LarsMolenschot/8x8_RGB_LED_CUBE/Spice_simulations/Power_rail_transients.asc

C1: cap; C10uF
C2: cap; C0.1uF
C3: cap; C0.1uF
C4: cap; C100pF
C5: cap; C0.1uF
C6: cap; C22uF
C7: cap; C22uF
D1: LED; D_RLED
D2: LED; D_RLED
D3: LED; D_RLED
D4: LED; D_RLED
D5: LED; D_RLED
D6: LED; D_RLED
D7: LED; D_RLED
D8: LED; D_RLED
L1: ind; 4.7µH; Rser=1m
R1: res; R10K
R2: res; R52.3K
R3: res; R10K
R4: res; R390
R5: res; R390
R6: res; R390
R7: res; R390
R8: res; R390
R9: res; R390
R10: res; R390
R11: res; R390
S1: sw; TSW
V1: voltage; 12
V2: voltage; PULSE(-1 1 0.5 1n 1n 0.5m 1m)
Named nets: 0, FB, Vo
.model TSW SW()
.model D_RLED D(Vfwd=2.0 Ron=0.1)
.tran 1
