LarsMolenschot/8x8_RGB_LED_CUBE/(list of files, drawings)

Other design files:
Spice_simulations/TPS562202_PSPICE_TRANS/TPS562202_TRANS.OPJ
Spice_simulations/TPS562202_PSPICE_TRANS/TPS562202DRL_TRANS.OLB
