LarsMolenschot/8x8_RGB_LED_CUBE/Led_cube_PCB/LED_CUBE_8x8/LED_CUBE_8x8.kicad_pcb

## KiCad design Led_cube_PCB/LED_CUBE_8x8/LED_CUBE_8x8.kicad_pcb (2026-08-15)

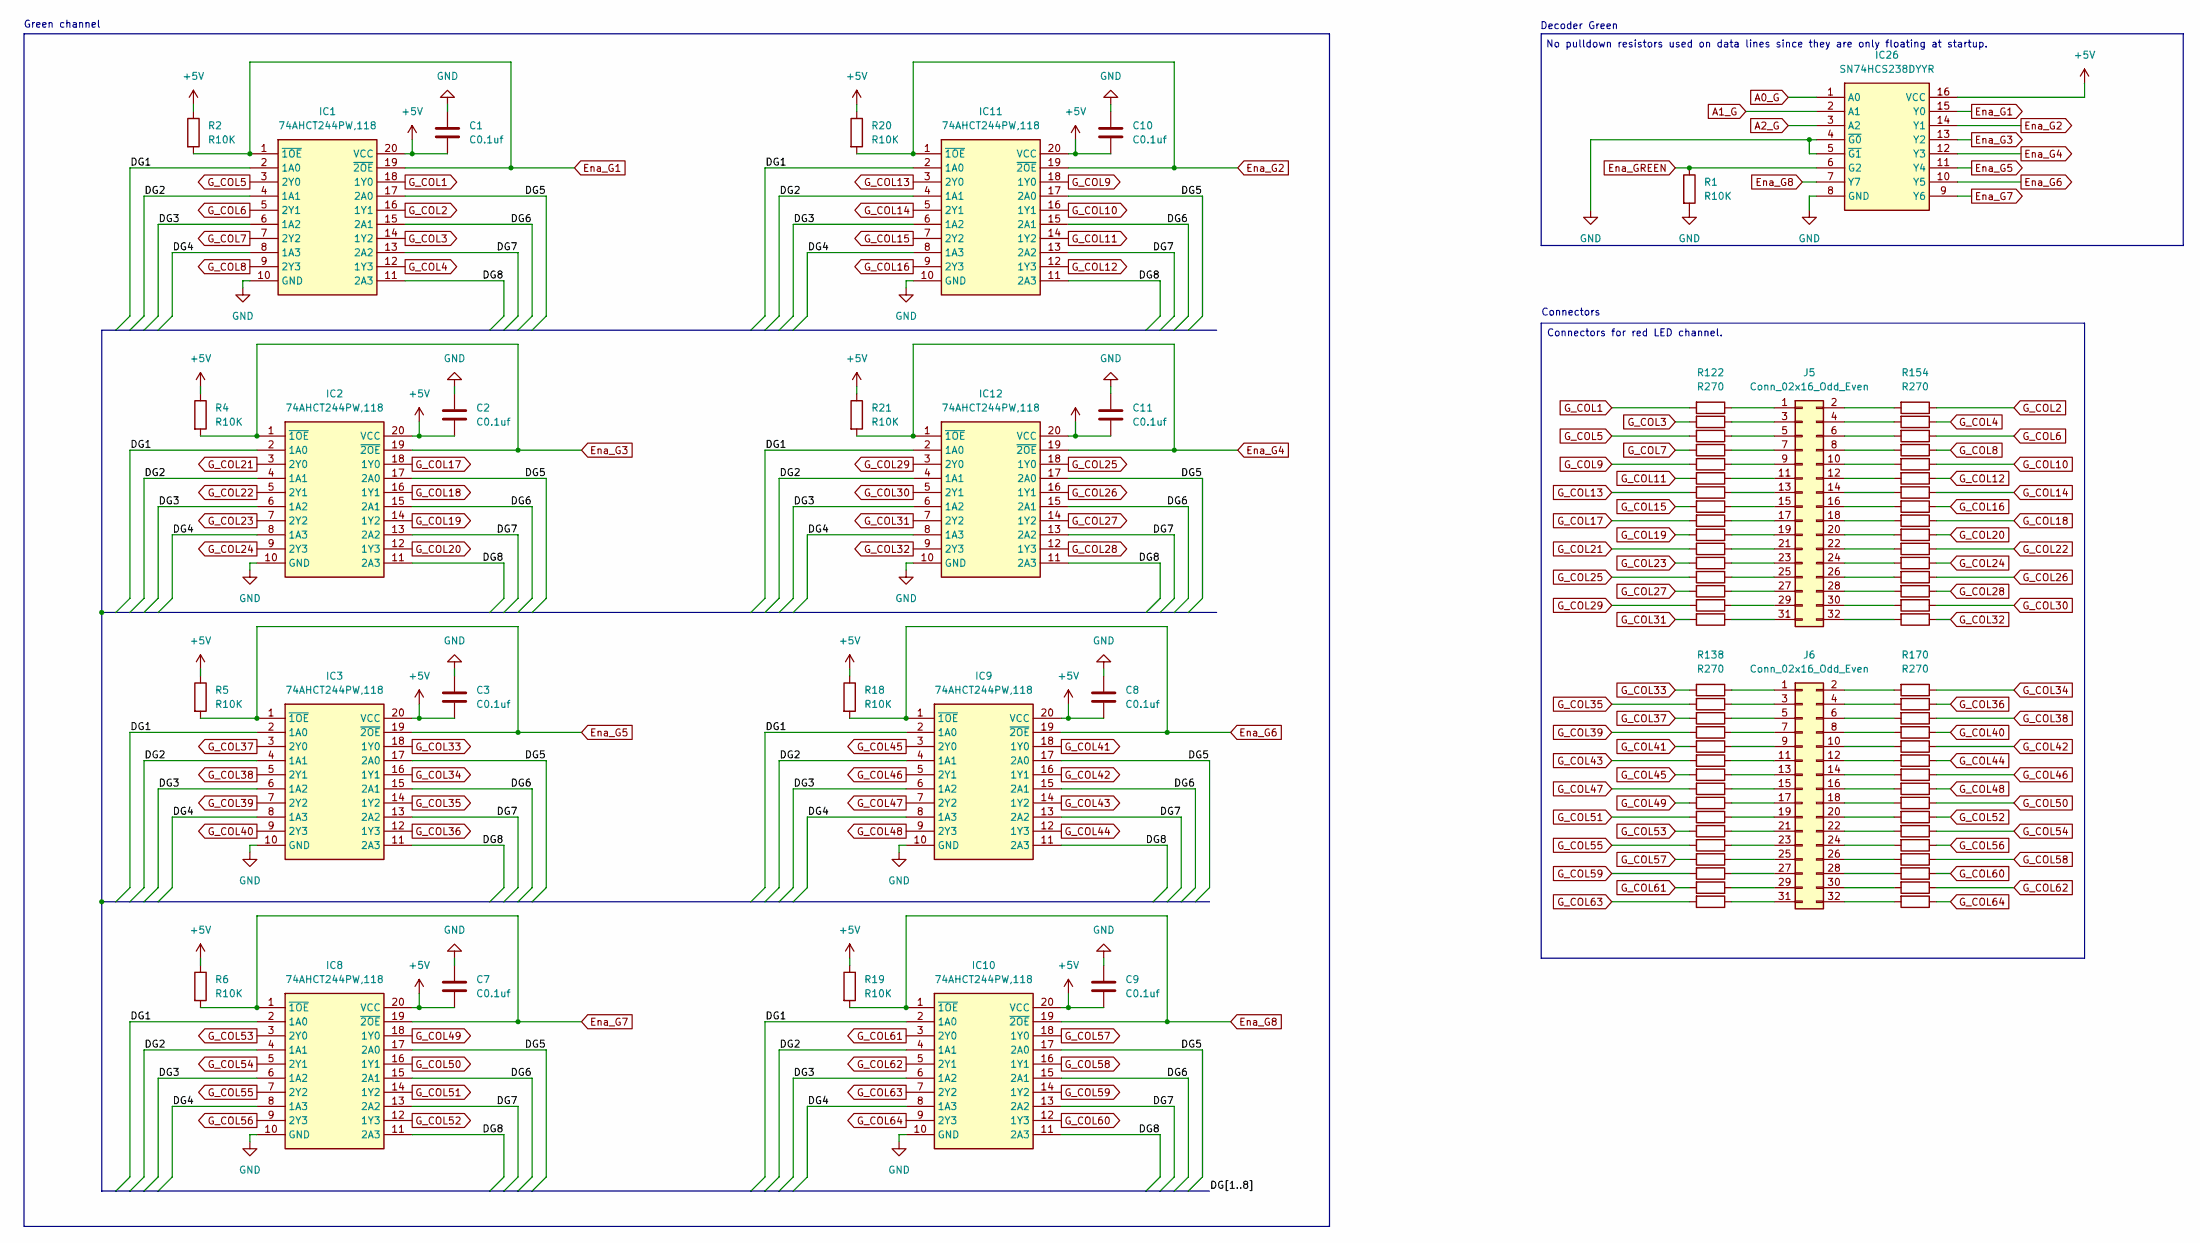
[picture p1: schematic Green_LEDS.kicad_sch, 8x8_Led_Cube]

Parts:
C1, C2, C3, C7, C8, C9, C10, C11: C0.1uf; C_0603_1608Metric_Pad1.08x0.95mm_HandSolder
IC1, IC2, IC3, IC8, IC9, IC10, IC11, IC12: 74AHCT244PW,118; SOP65P640X110-20N; Mouser Part Number 771-AHCT244PW118
IC26: SN74HCS238DYYR; SOP50P326X110-16N; Mouser Part Number 595-SN74HCS238DYYR
J5, J6: Conn_02x16_Odd_Even; PinSocket_2x16_P2.54mm_Vertical
R1, R2, R4, R5, R6, R18, R19, R20, R21: R10K; R_0603_1608Metric_Pad0.98x0.95mm_HandSolder
R122, R123, R124, R125, R126, R127, R128, R129, R130, R131, R132, R133, R134, R135, R136, R137, R138, R139, R140, R141, R142, R143, R144, R145, R146, R147, R148, R149, R150, R151, R152, R153, R154, R155, R156, R157, R158, R159, R160, R161, R162, R163, R164, R165, R166, R167, R168, R169, R170, R171, R172, R173, R174, R175, R176, R177, R178, R179, R180, R181, R182, R183, R184, R185: R270; R_0603_1608Metric_Pad0.98x0.95mm_HandSolder

Connections:
+5V: C1.2, C2.2, C3.2, C7.2, C8.2, C9.2, C10.2, C11.2, IC1.20 (VCC), IC2.20 (VCC), IC3.20 (VCC), IC8.20 (VCC), IC9.20 (VCC), IC10.20 (VCC), IC11.20 (VCC), IC12.20 (VCC), IC26.16 (VCC), R2.1, R4.1, R5.1, R6.1, R18.1, R19.1, R20.1, R21.1; also elsewhere on the board
/Green LED's/DG1: IC1.2 (1A0), IC2.2 (1A0), IC3.2 (1A0), IC8.2 (1A0), IC9.2 (1A0), IC10.2 (1A0), IC11.2 (1A0), IC12.2 (1A0)
/Green LED's/DG2: IC1.4 (1A1), IC2.4 (1A1), IC3.4 (1A1), IC8.4 (1A1), IC9.4 (1A1), IC10.4 (1A1), IC11.4 (1A1), IC12.4 (1A1)
/Green LED's/DG3: IC1.6 (1A2), IC2.6 (1A2), IC3.6 (1A2), IC8.6 (1A2), IC9.6 (1A2), IC10.6 (1A2), IC11.6 (1A2), IC12.6 (1A2)
/Green LED's/DG4: IC1.8 (1A3), IC2.8 (1A3), IC3.8 (1A3), IC8.8 (1A3), IC9.8 (1A3), IC10.8 (1A3), IC11.8 (1A3), IC12.8 (1A3)
/Green LED's/DG5: IC1.17 (2A0), IC2.17 (2A0), IC3.17 (2A0), IC8.17 (2A0), IC9.17 (2A0), IC10.17 (2A0), IC11.17 (2A0), IC12.17 (2A0)
/Green LED's/DG6: IC1.15 (2A1), IC2.15 (2A1), IC3.15 (2A1), IC8.15 (2A1), IC9.15 (2A1), IC10.15 (2A1), IC11.15 (2A1), IC12.15 (2A1)
/Green LED's/DG7: IC1.13 (2A2), IC2.13 (2A2), IC3.13 (2A2), IC8.13 (2A2), IC9.13 (2A2), IC10.13 (2A2), IC11.13 (2A2), IC12.13 (2A2)
/Green LED's/DG8: IC1.11 (2A3), IC2.11 (2A3), IC3.11 (2A3), IC8.11 (2A3), IC9.11 (2A3), IC10.11 (2A3), IC11.11 (2A3), IC12.11 (2A3)
A0_G: IC26.1 (A0); also elsewhere on the board
A1_G: IC26.2 (A1); also elsewhere on the board
A2_G: IC26.3 (A2); also elsewhere on the board
Ena_G1: IC1.1 (~1OE), IC1.19 (~2OE), IC26.15 (Y0), R2.2
Ena_G2: IC11.1 (~1OE), IC11.19 (~2OE), IC26.14 (Y1), R20.2
Ena_G3: IC2.1 (~1OE), IC2.19 (~2OE), IC26.13 (Y2), R4.2
Ena_G4: IC12.1 (~1OE), IC12.19 (~2OE), IC26.12 (Y3), R21.2
Ena_G5: IC3.1 (~1OE), IC3.19 (~2OE), IC26.11 (Y4), R5.2
Ena_G6: IC9.1 (~1OE), IC9.19 (~2OE), IC26.10 (Y5), R18.2
Ena_G7: IC8.1 (~1OE), IC8.19 (~2OE), IC26.9 (Y6), R6.2
Ena_G8: IC10.1 (~1OE), IC10.19 (~2OE), IC26.7 (Y7), R19.2
Ena_GREEN: IC26.6 (G2), R1.1
GND: C1.1, C2.1, C3.1, C7.1, C8.1, C9.1, C10.1, C11.1, IC1.10 (GND), IC2.10 (GND), IC3.10 (GND), IC8.10 (GND), IC9.10 (GND), IC10.10 (GND), IC11.10 (GND), IC12.10 (GND), IC26.4 (~G0), IC26.5 (~G1), IC26.8 (GND), R1.2; also elsewhere on the board
G_COL1: IC1.18 (1Y0), R122.2
G_COL2: IC1.16 (1Y1), R154.1
G_COL3: IC1.14 (1Y2), R123.2
G_COL4: IC1.12 (1Y3), R155.1
G_COL5: IC1.3 (2Y0), R124.2
G_COL6: IC1.5 (2Y1), R156.1
G_COL7: IC1.7 (2Y2), R125.2
G_COL8: IC1.9 (2Y3), R157.1
G_COL9: IC11.18 (1Y0), R126.2
G_COL10: IC11.16 (1Y1), R158.1
G_COL11: IC11.14 (1Y2), R127.2
G_COL12: IC11.12 (1Y3), R159.1
G_COL13: IC11.3 (2Y0), R128.2
G_COL14: IC11.5 (2Y1), R160.1
G_COL15: IC11.7 (2Y2), R129.2
G_COL16: IC11.9 (2Y3), R161.1
G_COL17: IC2.18 (1Y0), R130.2
G_COL18: IC2.16 (1Y1), R162.1
G_COL19: IC2.14 (1Y2), R131.2
G_COL20: IC2.12 (1Y3), R163.1
G_COL21: IC2.3 (2Y0), R132.2
G_COL22: IC2.5 (2Y1), R164.1
G_COL23: IC2.7 (2Y2), R133.2
G_COL24: IC2.9 (2Y3), R165.1
G_COL25: IC12.18 (1Y0), R134.2
G_COL26: IC12.16 (1Y1), R166.1
G_COL27: IC12.14 (1Y2), R135.2
G_COL28: IC12.12 (1Y3), R167.1
G_COL29: IC12.3 (2Y0), R136.2
G_COL30: IC12.5 (2Y1), R168.1
G_COL31: IC12.7 (2Y2), R137.2
G_COL32: IC12.9 (2Y3), R169.1
G_COL33: IC3.18 (1Y0), R138.2
G_COL34: IC3.16 (1Y1), R170.1
G_COL35: IC3.14 (1Y2), R139.2
G_COL36: IC3.12 (1Y3), R171.1
G_COL37: IC3.3 (2Y0), R140.2
G_COL38: IC3.5 (2Y1), R172.1
G_COL39: IC3.7 (2Y2), R141.2
G_COL40: IC3.9 (2Y3), R173.1
G_COL41: IC9.18 (1Y0), R142.2
G_COL42: IC9.16 (1Y1), R174.1
G_COL43: IC9.14 (1Y2), R143.2
G_COL44: IC9.12 (1Y3), R175.1
G_COL45: IC9.3 (2Y0), R144.2
G_COL46: IC9.5 (2Y1), R176.1
G_COL47: IC9.7 (2Y2), R145.2
G_COL48: IC9.9 (2Y3), R177.1
G_COL49: IC8.18 (1Y0), R146.2
G_COL50: IC8.16 (1Y1), R178.1
G_COL51: IC8.14 (1Y2), R147.2
G_COL52: IC8.12 (1Y3), R179.1
G_COL53: IC8.3 (2Y0), R148.2
G_COL54: IC8.5 (2Y1), R180.1
G_COL55: IC8.7 (2Y2), R149.2
G_COL56: IC8.9 (2Y3), R181.1
G_COL57: IC10.18 (1Y0), R150.2
G_COL58: IC10.16 (1Y1), R182.1
G_COL59: IC10.14 (1Y2), R151.2
G_COL60: IC10.12 (1Y3), R183.1
G_COL61: IC10.3 (2Y0), R152.2
G_COL62: IC10.5 (2Y1), R184.1
G_COL63: IC10.7 (2Y2), R153.2
G_COL64: IC10.9 (2Y3), R185.1
unnamed: J5.1, R122.1
unnamed: J5.2, R154.2
unnamed: J5.3, R123.1
unnamed: J5.4, R155.2
unnamed: J5.5, R124.1
unnamed: J5.6, R156.2
unnamed: J5.7, R125.1
unnamed: J5.8, R157.2
unnamed: J5.9, R126.1
unnamed: J5.10, R158.2
unnamed: J5.11, R127.1
unnamed: J5.12, R159.2
unnamed: J5.13, R128.1
unnamed: J5.14, R160.2
unnamed: J5.15, R129.1
unnamed: J5.16, R161.2
unnamed: J5.17, R130.1
unnamed: J5.18, R162.2
unnamed: J5.19, R131.1
unnamed: J5.20, R163.2
unnamed: J5.21, R132.1
unnamed: J5.22, R164.2
unnamed: J5.23, R133.1
unnamed: J5.24, R165.2
unnamed: J5.25, R134.1
unnamed: J5.26, R166.2
unnamed: J5.27, R135.1
unnamed: J5.28, R167.2
unnamed: J5.29, R136.1
unnamed: J5.30, R168.2
unnamed: J5.31, R137.1
unnamed: J5.32, R169.2
unnamed: J6.1, R138.1
unnamed: J6.2, R170.2
unnamed: J6.3, R139.1
unnamed: J6.4, R171.2
unnamed: J6.5, R140.1
unnamed: J6.6, R172.2
unnamed: J6.7, R141.1
unnamed: J6.8, R173.2
unnamed: J6.9, R142.1
unnamed: J6.10, R174.2
unnamed: J6.11, R143.1
unnamed: J6.12, R175.2
unnamed: J6.13, R144.1
unnamed: J6.14, R176.2
unnamed: J6.15, R145.1
unnamed: J6.16, R177.2
unnamed: J6.17, R146.1
unnamed: J6.18, R178.2
unnamed: J6.19, R147.1
unnamed: J6.20, R179.2
unnamed: J6.21, R148.1
unnamed: J6.22, R180.2
unnamed: J6.23, R149.1
unnamed: J6.24, R181.2
unnamed: J6.25, R150.1
unnamed: J6.26, R182.2
unnamed: J6.27, R151.1
unnamed: J6.28, R183.2
unnamed: J6.29, R152.1
unnamed: J6.30, R184.2
unnamed: J6.31, R153.1
unnamed: J6.32, R185.2

Notes on the sheet:
Connectors
Decoder Green
No pulldown resistors used on data lines since they are only floating at startup.
Green channel
Connectors for red LED channel.

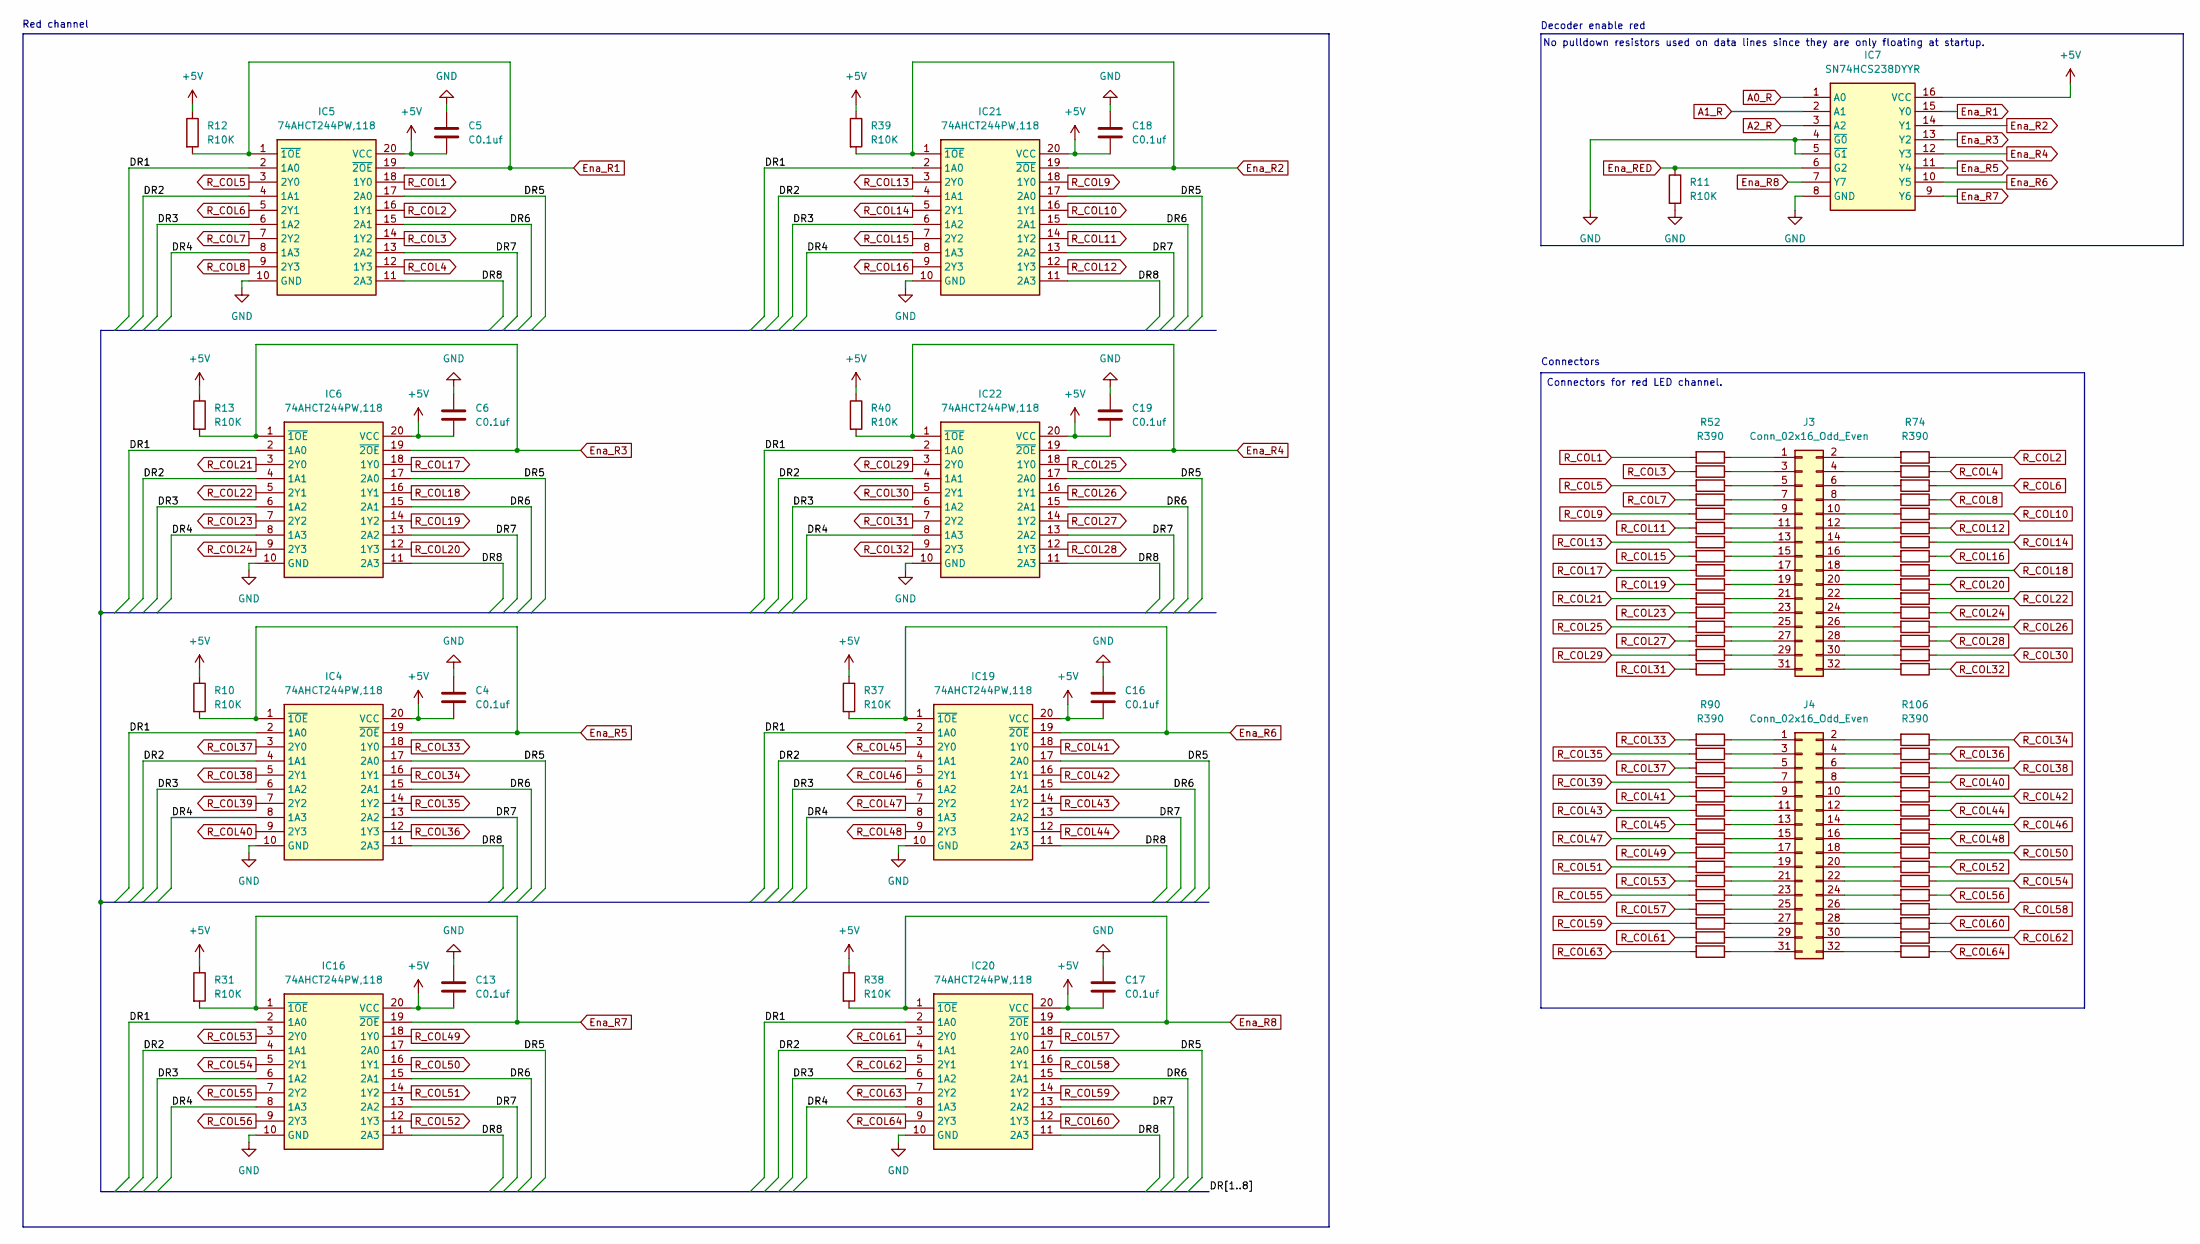
[picture p2: schematic Red_LEDS.kicad_sch, 8x8_Led_Cube]

Parts:
C4, C5, C6, C13, C16, C17, C18, C19: C0.1uf; C_0603_1608Metric_Pad1.08x0.95mm_HandSolder
IC4, IC5, IC6, IC16, IC19, IC20, IC21, IC22: 74AHCT244PW,118; SOP65P640X110-20N; Mouser Part Number 771-AHCT244PW118
IC7: SN74HCS238DYYR; SOP50P326X110-16N; Mouser Part Number 595-SN74HCS238DYYR
J3, J4: Conn_02x16_Odd_Even; PinSocket_2x16_P2.54mm_Vertical
R10, R11, R12, R13, R31, R37, R38, R39, R40: R10K; R_0603_1608Metric_Pad0.98x0.95mm_HandSolder
R52, R53, R60, R61, R62, R63, R64, R65, R66, R67, R68, R69, R70, R71, R72, R73, R74, R75, R76, R77, R78, R79, R80, R81, R82, R83, R84, R85, R86, R87, R88, R89, R90, R91, R92, R93, R94, R95, R96, R97, R98, R99, R100, R101, R102, R103, R104, R105, R106, R107, R108, R109, R110, R111, R112, R113, R114, R115, R116, R117, R118, R119, R120, R121: R390; R_0603_1608Metric_Pad0.98x0.95mm_HandSolder

Connections:
+5V: C4.2, C5.2, C6.2, C13.2, C16.2, C17.2, C18.2, C19.2, IC4.20 (VCC), IC5.20 (VCC), IC6.20 (VCC), IC7.16 (VCC), IC16.20 (VCC), IC19.20 (VCC), IC20.20 (VCC), IC21.20 (VCC), IC22.20 (VCC), R10.1, R12.1, R13.1, R31.1, R37.1, R38.1, R39.1, R40.1; also elsewhere on the board
/Red LED's/DR1: IC4.2 (1A0), IC5.2 (1A0), IC6.2 (1A0), IC16.2 (1A0), IC19.2 (1A0), IC20.2 (1A0), IC21.2 (1A0), IC22.2 (1A0)
/Red LED's/DR2: IC4.4 (1A1), IC5.4 (1A1), IC6.4 (1A1), IC16.4 (1A1), IC19.4 (1A1), IC20.4 (1A1), IC21.4 (1A1), IC22.4 (1A1)
/Red LED's/DR3: IC4.6 (1A2), IC5.6 (1A2), IC6.6 (1A2), IC16.6 (1A2), IC19.6 (1A2), IC20.6 (1A2), IC21.6 (1A2), IC22.6 (1A2)
/Red LED's/DR4: IC4.8 (1A3), IC5.8 (1A3), IC6.8 (1A3), IC16.8 (1A3), IC19.8 (1A3), IC20.8 (1A3), IC21.8 (1A3), IC22.8 (1A3)
/Red LED's/DR5: IC4.17 (2A0), IC5.17 (2A0), IC6.17 (2A0), IC16.17 (2A0), IC19.17 (2A0), IC20.17 (2A0), IC21.17 (2A0), IC22.17 (2A0)
/Red LED's/DR6: IC4.15 (2A1), IC5.15 (2A1), IC6.15 (2A1), IC16.15 (2A1), IC19.15 (2A1), IC20.15 (2A1), IC21.15 (2A1), IC22.15 (2A1)
/Red LED's/DR7: IC4.13 (2A2), IC5.13 (2A2), IC6.13 (2A2), IC16.13 (2A2), IC19.13 (2A2), IC20.13 (2A2), IC21.13 (2A2), IC22.13 (2A2)
/Red LED's/DR8: IC4.11 (2A3), IC5.11 (2A3), IC6.11 (2A3), IC16.11 (2A3), IC19.11 (2A3), IC20.11 (2A3), IC21.11 (2A3), IC22.11 (2A3)
A0_R: IC7.1 (A0); also elsewhere on the board
A1_R: IC7.2 (A1); also elsewhere on the board
A2_R: IC7.3 (A2); also elsewhere on the board
Ena_R1: IC5.1 (~1OE), IC5.19 (~2OE), IC7.15 (Y0), R12.2
Ena_R2: IC7.14 (Y1), IC21.1 (~1OE), IC21.19 (~2OE), R39.2
Ena_R3: IC6.1 (~1OE), IC6.19 (~2OE), IC7.13 (Y2), R13.2
Ena_R4: IC7.12 (Y3), IC22.1 (~1OE), IC22.19 (~2OE), R40.2
Ena_R5: IC4.1 (~1OE), IC4.19 (~2OE), IC7.11 (Y4), R10.2
Ena_R6: IC7.10 (Y5), IC19.1 (~1OE), IC19.19 (~2OE), R37.2
Ena_R7: IC7.9 (Y6), IC16.1 (~1OE), IC16.19 (~2OE), R31.2
Ena_R8: IC7.7 (Y7), IC20.1 (~1OE), IC20.19 (~2OE), R38.2
Ena_RED: IC7.6 (G2), R11.1
GND: C4.1, C5.1, C6.1, C13.1, C16.1, C17.1, C18.1, C19.1, IC4.10 (GND), IC5.10 (GND), IC6.10 (GND), IC7.4 (~G0), IC7.5 (~G1), IC7.8 (GND), IC16.10 (GND), IC19.10 (GND), IC20.10 (GND), IC21.10 (GND), IC22.10 (GND), R11.2; also elsewhere on the board
unnamed: J3.1, R52.1
unnamed: J3.2, R74.2
unnamed: J3.3, R53.1
unnamed: J3.4, R75.2
unnamed: J3.5, R60.1
unnamed: J3.6, R76.2
unnamed: J3.7, R61.1
unnamed: J3.8, R77.2
unnamed: J3.9, R62.1
unnamed: J3.10, R78.2
unnamed: J3.11, R63.1
unnamed: J3.12, R79.2
unnamed: J3.13, R64.1
unnamed: J3.14, R80.2
unnamed: J3.15, R65.1
unnamed: J3.16, R81.2
unnamed: J3.17, R66.1
unnamed: J3.18, R82.2
unnamed: J3.19, R67.1
unnamed: J3.20, R83.2
unnamed: J3.21, R68.1
unnamed: J3.22, R84.2
unnamed: J3.23, R69.1
unnamed: J3.24, R85.2
unnamed: J3.25, R70.1
unnamed: J3.26, R86.2
unnamed: J3.27, R71.1
unnamed: J3.28, R87.2
unnamed: J3.29, R72.1
unnamed: J3.30, R88.2
unnamed: J3.31, R73.1
unnamed: J3.32, R89.2
unnamed: J4.1, R90.1
unnamed: J4.2, R106.2
unnamed: J4.3, R91.1
unnamed: J4.4, R107.2
unnamed: J4.5, R92.1
unnamed: J4.6, R108.2
unnamed: J4.7, R93.1
unnamed: J4.8, R109.2
unnamed: J4.9, R94.1
unnamed: J4.10, R110.2
unnamed: J4.11, R95.1
unnamed: J4.12, R111.2
unnamed: J4.13, R96.1
unnamed: J4.14, R112.2
unnamed: J4.15, R97.1
unnamed: J4.16, R113.2
unnamed: J4.17, R98.1
unnamed: J4.18, R114.2
unnamed: J4.19, R99.1
unnamed: J4.20, R115.2
unnamed: J4.21, R100.1
unnamed: J4.22, R116.2
unnamed: J4.23, R101.1
unnamed: J4.24, R117.2
unnamed: J4.25, R102.1
unnamed: J4.26, R118.2
unnamed: J4.27, R103.1
unnamed: J4.28, R119.2
unnamed: J4.29, R104.1
unnamed: J4.30, R120.2
unnamed: J4.31, R105.1
unnamed: J4.32, R121.2
R_COL1: IC5.18 (1Y0), R52.2
R_COL2: IC5.16 (1Y1), R74.1
R_COL3: IC5.14 (1Y2), R53.2
R_COL4: IC5.12 (1Y3), R75.1
R_COL5: IC5.3 (2Y0), R60.2
R_COL6: IC5.5 (2Y1), R76.1
R_COL7: IC5.7 (2Y2), R61.2
R_COL8: IC5.9 (2Y3), R77.1
R_COL9: IC21.18 (1Y0), R62.2
R_COL10: IC21.16 (1Y1), R78.1
R_COL11: IC21.14 (1Y2), R63.2
R_COL12: IC21.12 (1Y3), R79.1
R_COL13: IC21.3 (2Y0), R64.2
R_COL14: IC21.5 (2Y1), R80.1
R_COL15: IC21.7 (2Y2), R65.2
R_COL16: IC21.9 (2Y3), R81.1
R_COL17: IC6.18 (1Y0), R66.2
R_COL18: IC6.16 (1Y1), R82.1
R_COL19: IC6.14 (1Y2), R67.2
R_COL20: IC6.12 (1Y3), R83.1
R_COL21: IC6.3 (2Y0), R68.2
R_COL22: IC6.5 (2Y1), R84.1
R_COL23: IC6.7 (2Y2), R69.2
R_COL24: IC6.9 (2Y3), R85.1
R_COL25: IC22.18 (1Y0), R70.2
R_COL26: IC22.16 (1Y1), R86.1
R_COL27: IC22.14 (1Y2), R71.2
R_COL28: IC22.12 (1Y3), R87.1
R_COL29: IC22.3 (2Y0), R72.2
R_COL30: IC22.5 (2Y1), R88.1
R_COL31: IC22.7 (2Y2), R73.2
R_COL32: IC22.9 (2Y3), R89.1
R_COL33: IC4.18 (1Y0), R90.2
R_COL34: IC4.16 (1Y1), R106.1
R_COL35: IC4.14 (1Y2), R91.2
R_COL36: IC4.12 (1Y3), R107.1
R_COL37: IC4.3 (2Y0), R92.2
R_COL38: IC4.5 (2Y1), R108.1
R_COL39: IC4.7 (2Y2), R93.2
R_COL40: IC4.9 (2Y3), R109.1
R_COL41: IC19.18 (1Y0), R94.2
R_COL42: IC19.16 (1Y1), R110.1
R_COL43: IC19.14 (1Y2), R95.2
R_COL44: IC19.12 (1Y3), R111.1
R_COL45: IC19.3 (2Y0), R96.2
R_COL46: IC19.5 (2Y1), R112.1
R_COL47: IC19.7 (2Y2), R97.2
R_COL48: IC19.9 (2Y3), R113.1
R_COL49: IC16.18 (1Y0), R98.2
R_COL50: IC16.16 (1Y1), R114.1
R_COL51: IC16.14 (1Y2), R99.2
R_COL52: IC16.12 (1Y3), R115.1
R_COL53: IC16.3 (2Y0), R100.2
R_COL54: IC16.5 (2Y1), R116.1
R_COL55: IC16.7 (2Y2), R101.2
R_COL56: IC16.9 (2Y3), R117.1
R_COL57: IC20.18 (1Y0), R102.2
R_COL58: IC20.16 (1Y1), R118.1
R_COL59: IC20.14 (1Y2), R103.2
R_COL60: IC20.12 (1Y3), R119.1
R_COL61: IC20.3 (2Y0), R104.2
R_COL62: IC20.5 (2Y1), R120.1
R_COL63: IC20.7 (2Y2), R105.2
R_COL64: IC20.9 (2Y3), R121.1

Notes on the sheet:
Connectors
Red channel
No pulldown resistors used on data lines since they are only floating at startup.
Decoder enable red
Connectors for red LED channel.

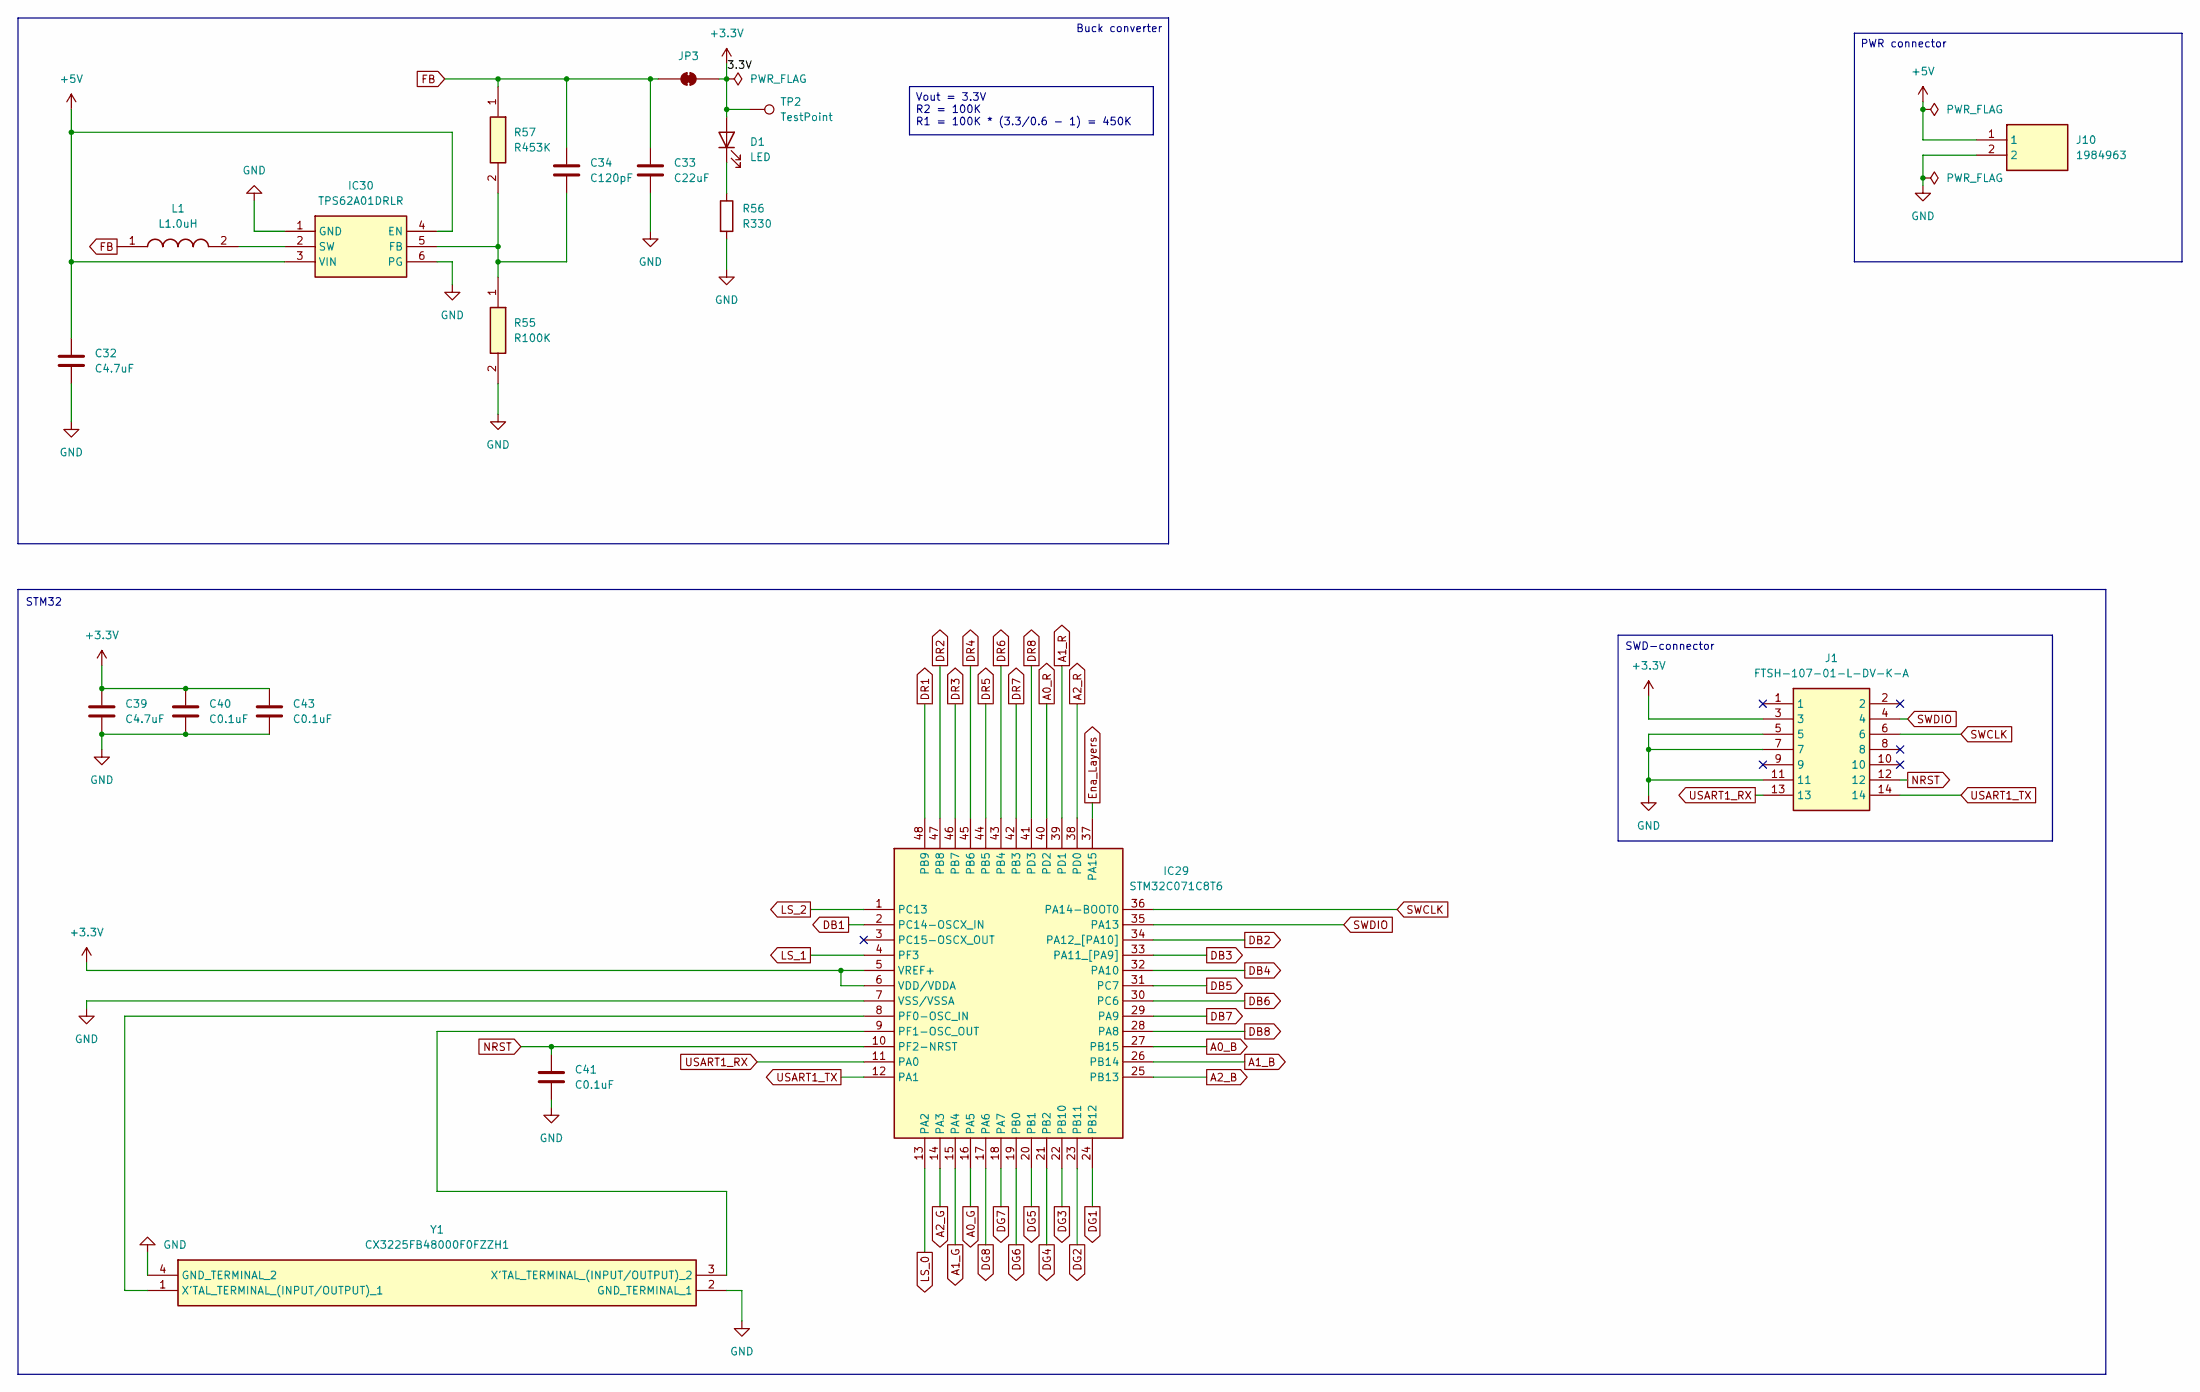
[picture p3: schematic STM32_sch.kicad_sch, 8x8_Led_Cube]

Parts:
C32, C39: C4.7uF; C_0603_1608Metric_Pad1.08x0.95mm_HandSolder
C33: C22uF; C_0603_1608Metric_Pad1.08x0.95mm_HandSolder
C34: C120pF; C_0603_1608Metric_Pad1.08x0.95mm_HandSolder
C40, C41, C43: C0.1uF; C_0603_1608Metric_Pad1.08x0.95mm_HandSolder
D1: LED; LED_0805_2012Metric_Pad1.15x1.40mm_HandSolder
IC29: STM32C071C8T6; QFP50P900X900X160-48N; Mouser Part Number 511-STM32C071C8T6
IC30: TPS62A01DRLR; SOTFL50P160X60-6N; Mouser Part Number 595-TPS62A01DRLR
J1: FTSH-107-01-L-DV-K-A; FTSH-107-XX-YYY-DV-K-A; Mouser Part Number 200-FTSH10701LDVKA
J10: 1984963; Mouser Part Number 651-1984963
JP3: SolderJumper_2_Bridged; SolderJumper-2_P1.3mm_Open_RoundedPad1.0x1.5mm
L1: L1.0uH; DFE2HCAH1R0MJ0L; Mouser Part Number 81-DFE252012F-1R0MP2
R55: R100K; R_0603_1608Metric_Pad0.98x0.95mm_HandSolder; Mouser Part Number 603-SR0603FR-07100KL
R56: R330; R_0603_1608Metric_Pad0.98x0.95mm_HandSolder
R57: R453K; R_0603_1608Metric_Pad0.98x0.95mm_HandSolder; Mouser Part Number 603-AF0603FR-07453KL
TP2: TestPoint; TestPoint_Pad_D2.0mm
Y1: CX3225FB48000F0FZZH1; Manufacturer_Part_Number CX3225FB48000F0FZZH1

Connections:
+3.3V: C39.1, C40.1, C43.1, D1.2 (A), IC29.5 (VREF+), IC29.6 (VDD/VDDA), J1.3, JP3.1 (A), TP2.1 (1_1); also elsewhere on the board
+5V: C32.1, IC30.3 (VIN), IC30.4 (EN), J10.1; also elsewhere on the board
A0_B: IC29.27 (PB15); also elsewhere on the board
A0_G: IC29.16 (PA5); also elsewhere on the board
A0_R: IC29.40 (PD2); also elsewhere on the board
A1_B: IC29.26 (PB14); also elsewhere on the board
A1_G: IC29.15 (PA4); also elsewhere on the board
A1_R: IC29.39 (PD1); also elsewhere on the board
A2_B: IC29.25 (PB13); also elsewhere on the board
A2_G: IC29.14 (PA3); also elsewhere on the board
A2_R: IC29.38 (PD0); also elsewhere on the board
DB1: IC29.2 (PC14-OSCX_IN)
DB2: IC29.34 (PA12_[PA10])
DB3: IC29.33 (PA11_[PA9])
DB4: IC29.32 (PA10)
DB5: IC29.31 (PC7)
DB6: IC29.30 (PC6)
DB7: IC29.29 (PA9)
DB8: IC29.28 (PA8)
DG1: IC29.24 (PB12)
DG2: IC29.23 (PB11)
DG3: IC29.22 (PB10)
DG4: IC29.21 (PB2)
DG5: IC29.20 (PB1)
DG6: IC29.19 (PB0)
DG7: IC29.18 (PA7)
DG8: IC29.17 (PA6)
DR1: IC29.48 (PB9)
DR2: IC29.47 (PB8)
DR3: IC29.46 (PB7)
DR4: IC29.45 (PB6)
DR5: IC29.44 (PB5)
DR6: IC29.43 (PB4)
DR7: IC29.42 (PB3)
DR8: IC29.41 (PD3)
Ena_Layers: IC29.37 (PA15); also elsewhere on the board
FB: C33.1, C34.1, JP3.2 (B), L1.1, R57.1
GND: C32.2, C33.2, C39.2, C40.2, C41.2, C43.2, IC29.7 (VSS/VSSA), IC30.1 (GND), IC30.6 (PG), J1.5, J1.7, J1.11, J10.2, R55.2, R56.2, Y1.2 (GND_TERMINAL_1), Y1.4 (GND_TERMINAL_2); also elsewhere on the board
LS_0: IC29.13 (PA2); also elsewhere on the board
LS_1: IC29.4 (PF3); also elsewhere on the board
LS_2: IC29.1 (PC13); also elsewhere on the board
NRST: C41.1, IC29.10 (PF2-NRST), J1.12; also elsewhere on the board
unnamed: D1.1 (K), R56.1
unnamed: IC29.8 (PF0-OSC_IN), Y1.1 (X'TAL_TERMINAL_(INPUT/OUTPUT)_1)
unnamed: IC29.9 (PF1-OSC_OUT), Y1.3 (X'TAL_TERMINAL_(INPUT/OUTPUT)_2)
unnamed: C34.2, IC30.5 (FB), R55.1, R57.2
unnamed: IC30.2 (SW), L1.2
SWCLK: IC29.36 (PA14-BOOT0), J1.6
SWDIO: IC29.35 (PA13), J1.4

Notes on the sheet:
SWD-connector
STM32
Vout = 3.3V R2 = 100K R1 = 100K * (3.3/0.6 - 1) = 450K
PWR connector
Buck converter

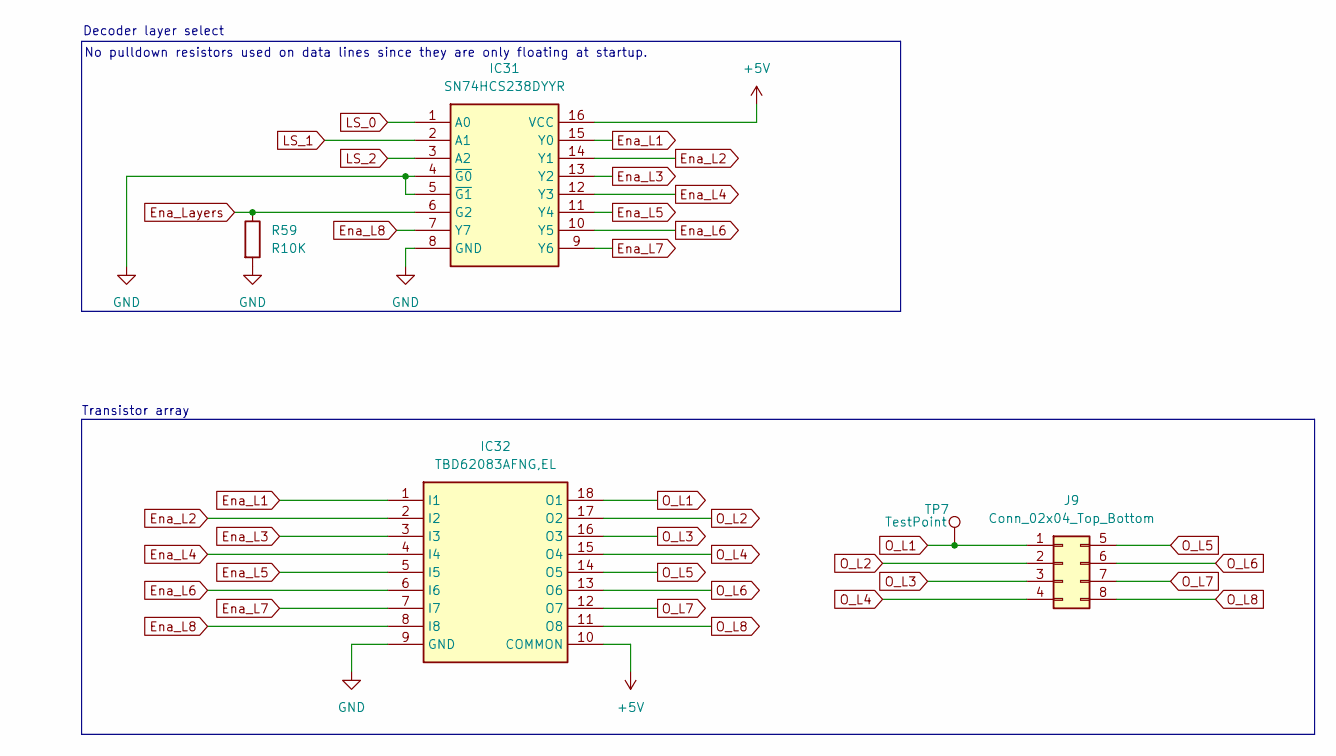
[picture p4: schematic Layer_select.kicad_sch, 8x8_Led_Cube]

Parts:
IC31: SN74HCS238DYYR; SOP50P326X110-16N; Mouser Part Number 595-SN74HCS238DYYR
IC32: TBD62083AFNG,EL; SOIC127P1030X245-18N; Mouser Part Number 757-TBD62083AFNGEL
J9: Conn_02x04_Top_Bottom; PinHeader_2x04_P2.54mm_Vertical
R59: R10K; R_0603_1608Metric_Pad0.98x0.95mm_HandSolder
TP7: TestPoint; TestPoint_Pad_D2.0mm

Connections:
+5V: IC31.16 (VCC), IC32.10 (COMMON); also elsewhere on the board
Ena_L1: IC31.15 (Y0), IC32.1 (I1)
Ena_L2: IC31.14 (Y1), IC32.2 (I2)
Ena_L3: IC31.13 (Y2), IC32.3 (I3)
Ena_L4: IC31.12 (Y3), IC32.4 (I4)
Ena_L5: IC31.11 (Y4), IC32.5 (I5)
Ena_L6: IC31.10 (Y5), IC32.6 (I6)
Ena_L7: IC31.9 (Y6), IC32.7 (I7)
Ena_L8: IC31.7 (Y7), IC32.8 (I8)
Ena_Layers: IC31.6 (G2), R59.1; also elsewhere on the board
GND: IC31.4 (~G0), IC31.5 (~G1), IC31.8 (GND), IC32.9 (GND), R59.2; also elsewhere on the board
LS_0: IC31.1 (A0); also elsewhere on the board
LS_1: IC31.2 (A1); also elsewhere on the board
LS_2: IC31.3 (A2); also elsewhere on the board
O_L1: IC32.18 (O1), J9.1, TP7.1 (1_1)
O_L2: IC32.17 (O2), J9.2
O_L3: IC32.16 (O3), J9.3
O_L4: IC32.15 (O4), J9.4
O_L5: IC32.14 (O5), J9.5
O_L6: IC32.13 (O6), J9.6
O_L7: IC32.12 (O7), J9.7
O_L8: IC32.11 (O8), J9.8

Notes on the sheet:
No pulldown resistors used on data lines since they are only floating at startup.
Transistor array
Decoder layer select
