LarsMolenschot/8x8_RGB_LED_CUBE/Led_cube_PCB/LED_CUBE_8x8/LED_CUBE_8x8.kicad_pcb

## KiCad design Led_cube_PCB/LED_CUBE_8x8/LED_CUBE_8x8.kicad_pcb (continued)

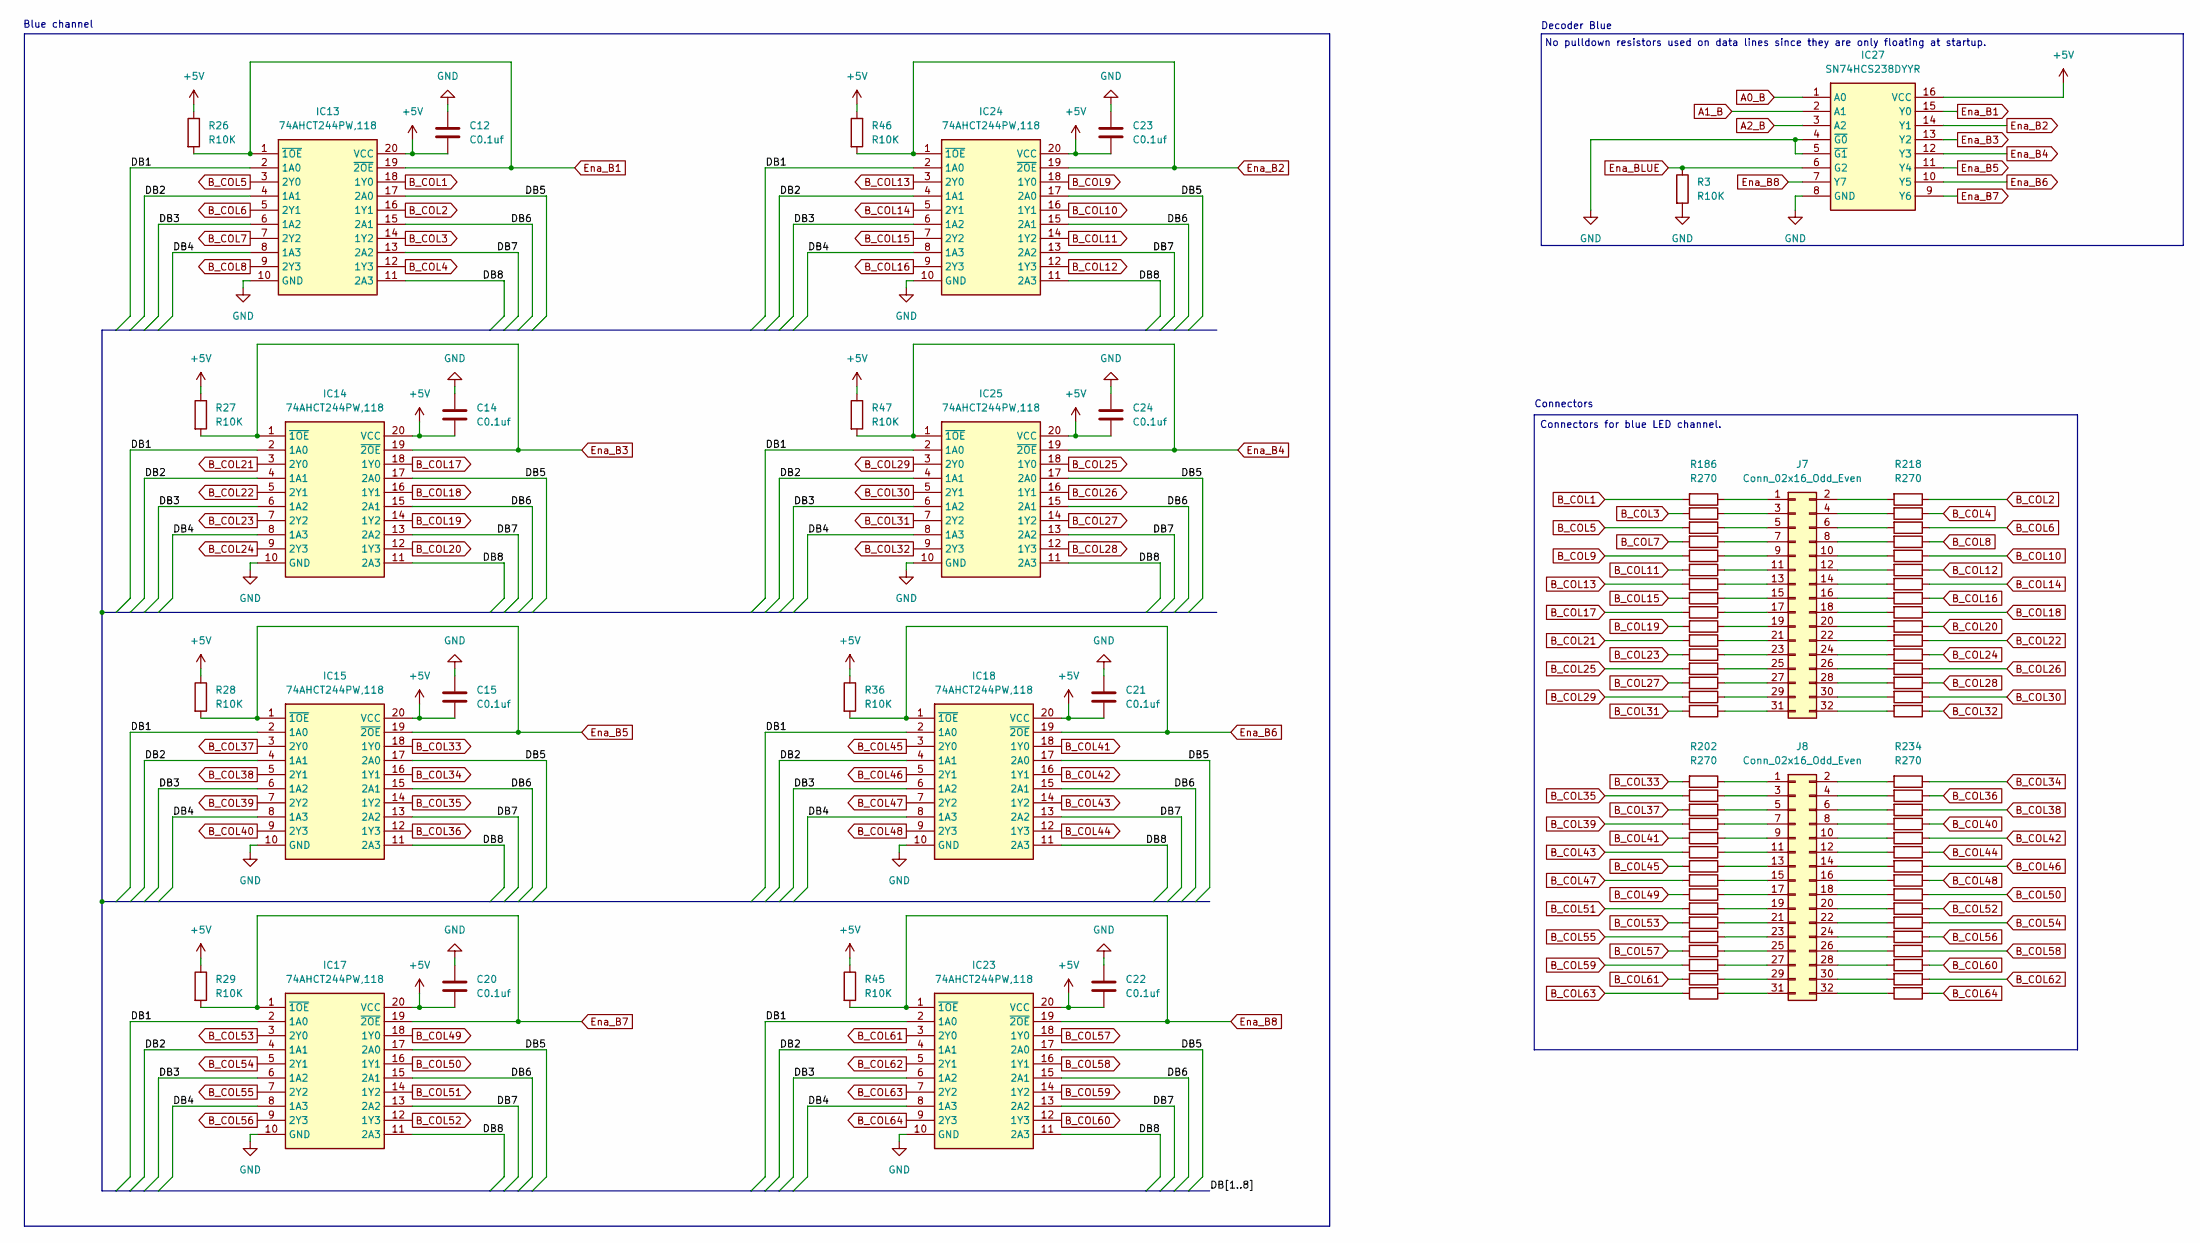
[picture p5: schematic Blue_LEDS.kicad_sch, 8x8_Led_Cube]

Parts:
C12, C14, C15, C20, C21, C22, C23, C24: C0.1uf; C_0603_1608Metric_Pad1.08x0.95mm_HandSolder
IC13, IC14, IC15, IC17, IC18, IC23, IC24, IC25: 74AHCT244PW,118; SOP65P640X110-20N; Mouser Part Number 771-AHCT244PW118
IC27: SN74HCS238DYYR; SOP50P326X110-16N; Mouser Part Number 595-SN74HCS238DYYR
J7, J8: Conn_02x16_Odd_Even; PinSocket_2x16_P2.54mm_Vertical
R3, R26, R27, R28, R29, R36, R45, R46, R47: R10K; R_0603_1608Metric_Pad0.98x0.95mm_HandSolder
R186, R187, R188, R189, R190, R191, R192, R193, R194, R195, R196, R197, R198, R199, R200, R201, R202, R203, R204, R205, R206, R207, R208, R209, R210, R211, R212, R213, R214, R215, R216, R217, R218, R219, R220, R221, R222, R223, R224, R225, R226, R227, R228, R229, R230, R231, R232, R233, R234, R235, R236, R237, R238, R239, R240, R241, R242, R243, R244, R245, R246, R247, R248, R249: R270; R_0603_1608Metric_Pad0.98x0.95mm_HandSolder

Connections:
+5V: C12.2, C14.2, C15.2, C20.2, C21.2, C22.2, C23.2, C24.1, IC13.20 (VCC), IC14.20 (VCC), IC15.20 (VCC), IC17.20 (VCC), IC18.20 (VCC), IC23.20 (VCC), IC24.20 (VCC), IC25.20 (VCC), IC27.16 (VCC), R26.1, R27.1, R28.1, R29.1, R36.1, R45.1, R46.1, R47.1; also elsewhere on the board
/Blue LED's/DB1: IC13.2 (1A0), IC14.2 (1A0), IC15.2 (1A0), IC17.2 (1A0), IC18.2 (1A0), IC23.2 (1A0), IC24.2 (1A0), IC25.2 (1A0)
/Blue LED's/DB2: IC13.4 (1A1), IC14.4 (1A1), IC15.4 (1A1), IC17.4 (1A1), IC18.4 (1A1), IC23.4 (1A1), IC24.4 (1A1), IC25.4 (1A1)
/Blue LED's/DB3: IC13.6 (1A2), IC14.6 (1A2), IC15.6 (1A2), IC17.6 (1A2), IC18.6 (1A2), IC23.6 (1A2), IC24.6 (1A2), IC25.6 (1A2)
/Blue LED's/DB4: IC13.8 (1A3), IC14.8 (1A3), IC15.8 (1A3), IC17.8 (1A3), IC18.8 (1A3), IC23.8 (1A3), IC24.8 (1A3), IC25.8 (1A3)
/Blue LED's/DB5: IC13.17 (2A0), IC14.17 (2A0), IC15.17 (2A0), IC17.17 (2A0), IC18.17 (2A0), IC23.17 (2A0), IC24.17 (2A0), IC25.17 (2A0)
/Blue LED's/DB6: IC13.15 (2A1), IC14.15 (2A1), IC15.15 (2A1), IC17.15 (2A1), IC18.15 (2A1), IC23.15 (2A1), IC24.15 (2A1), IC25.15 (2A1)
/Blue LED's/DB7: IC13.13 (2A2), IC14.13 (2A2), IC15.13 (2A2), IC17.13 (2A2), IC18.13 (2A2), IC23.13 (2A2), IC24.13 (2A2), IC25.13 (2A2)
/Blue LED's/DB8: IC13.11 (2A3), IC14.11 (2A3), IC15.11 (2A3), IC17.11 (2A3), IC18.11 (2A3), IC23.11 (2A3), IC24.11 (2A3), IC25.11 (2A3)
A0_B: IC27.1 (A0); also elsewhere on the board
A1_B: IC27.2 (A1); also elsewhere on the board
A2_B: IC27.3 (A2); also elsewhere on the board
B_COL1: IC13.18 (1Y0), R186.2
B_COL2: IC13.16 (1Y1), R218.1
B_COL3: IC13.14 (1Y2), R187.2
B_COL4: IC13.12 (1Y3), R219.1
B_COL5: IC13.3 (2Y0), R188.2
B_COL6: IC13.5 (2Y1), R220.1
B_COL7: IC13.7 (2Y2), R189.2
B_COL8: IC13.9 (2Y3), R221.1
B_COL9: IC24.18 (1Y0), R190.2
B_COL10: IC24.16 (1Y1), R222.1
B_COL11: IC24.14 (1Y2), R191.2
B_COL12: IC24.12 (1Y3), R223.1
B_COL13: IC24.3 (2Y0), R192.2
B_COL14: IC24.5 (2Y1), R224.1
B_COL15: IC24.7 (2Y2), R193.2
B_COL16: IC24.9 (2Y3), R225.1
B_COL17: IC14.18 (1Y0), R194.2
B_COL18: IC14.16 (1Y1), R226.1
B_COL19: IC14.14 (1Y2), R195.2
B_COL20: IC14.12 (1Y3), R227.1
B_COL21: IC14.3 (2Y0), R196.2
B_COL22: IC14.5 (2Y1), R228.1
B_COL23: IC14.7 (2Y2), R197.2
B_COL24: IC14.9 (2Y3), R229.1
B_COL25: IC25.18 (1Y0), R198.2
B_COL26: IC25.16 (1Y1), R230.1
B_COL27: IC25.14 (1Y2), R199.2
B_COL28: IC25.12 (1Y3), R231.1
B_COL29: IC25.3 (2Y0), R200.2
B_COL30: IC25.5 (2Y1), R232.1
B_COL31: IC25.7 (2Y2), R201.2
B_COL32: IC25.9 (2Y3), R233.1
B_COL33: IC15.18 (1Y0), R202.2
B_COL34: IC15.16 (1Y1), R234.1
B_COL35: IC15.14 (1Y2), R203.2
B_COL36: IC15.12 (1Y3), R235.1
B_COL37: IC15.3 (2Y0), R204.2
B_COL38: IC15.5 (2Y1), R236.1
B_COL39: IC15.7 (2Y2), R205.2
B_COL40: IC15.9 (2Y3), R237.1
B_COL41: IC18.18 (1Y0), R206.2
B_COL42: IC18.16 (1Y1), R238.1
B_COL43: IC18.14 (1Y2), R207.2
B_COL44: IC18.12 (1Y3), R239.1
B_COL45: IC18.3 (2Y0), R208.2
B_COL46: IC18.5 (2Y1), R240.1
B_COL47: IC18.7 (2Y2), R209.2
B_COL48: IC18.9 (2Y3), R241.1
B_COL49: IC17.18 (1Y0), R210.2
B_COL50: IC17.16 (1Y1), R242.1
B_COL51: IC17.14 (1Y2), R211.2
B_COL52: IC17.12 (1Y3), R243.1
B_COL53: IC17.3 (2Y0), R212.2
B_COL54: IC17.5 (2Y1), R244.1
B_COL55: IC17.7 (2Y2), R213.2
B_COL56: IC17.9 (2Y3), R245.1
B_COL57: IC23.18 (1Y0), R214.2
B_COL58: IC23.16 (1Y1), R246.1
B_COL59: IC23.14 (1Y2), R215.2
B_COL60: IC23.12 (1Y3), R247.1
B_COL61: IC23.3 (2Y0), R216.2
B_COL62: IC23.5 (2Y1), R248.1
B_COL63: IC23.7 (2Y2), R217.2
B_COL64: IC23.9 (2Y3), R249.1
Ena_B1: IC13.1 (~1OE), IC13.19 (~2OE), IC27.15 (Y0), R26.2
Ena_B2: IC24.1 (~1OE), IC24.19 (~2OE), IC27.14 (Y1), R46.2
Ena_B3: IC14.1 (~1OE), IC14.19 (~2OE), IC27.13 (Y2), R27.2
Ena_B4: IC25.1 (~1OE), IC25.19 (~2OE), IC27.12 (Y3), R47.2
Ena_B5: IC15.1 (~1OE), IC15.19 (~2OE), IC27.11 (Y4), R28.2
Ena_B6: IC18.1 (~1OE), IC18.19 (~2OE), IC27.10 (Y5), R36.2
Ena_B7: IC17.1 (~1OE), IC17.19 (~2OE), IC27.9 (Y6), R29.2
Ena_B8: IC23.1 (~1OE), IC23.19 (~2OE), IC27.7 (Y7), R45.2
Ena_BLUE: IC27.6 (G2), R3.1
GND: C12.1, C14.1, C15.1, C20.1, C21.1, C22.1, C23.1, C24.2, IC13.10 (GND), IC14.10 (GND), IC15.10 (GND), IC17.10 (GND), IC18.10 (GND), IC23.10 (GND), IC24.10 (GND), IC25.10 (GND), IC27.4 (~G0), IC27.5 (~G1), IC27.8 (GND), R3.2; also elsewhere on the board
unnamed: J7.1, R186.1
unnamed: J7.2, R218.2
unnamed: J7.3, R187.1
unnamed: J7.4, R219.2
unnamed: J7.5, R188.1
unnamed: J7.6, R220.2
unnamed: J7.7, R189.1
unnamed: J7.8, R221.2
unnamed: J7.9, R190.1
unnamed: J7.10, R222.2
unnamed: J7.11, R191.1
unnamed: J7.12, R223.2
unnamed: J7.13, R192.1
unnamed: J7.14, R224.2
unnamed: J7.15, R193.1
unnamed: J7.16, R225.2
unnamed: J7.17, R194.1
unnamed: J7.18, R226.2
unnamed: J7.19, R195.1
unnamed: J7.20, R227.2
unnamed: J7.21, R196.1
unnamed: J7.22, R228.2
unnamed: J7.23, R197.1
unnamed: J7.24, R229.2
unnamed: J7.25, R198.1
unnamed: J7.26, R230.2
unnamed: J7.27, R199.1
unnamed: J7.28, R231.2
unnamed: J7.29, R200.1
unnamed: J7.30, R232.2
unnamed: J7.31, R201.1
unnamed: J7.32, R233.2
unnamed: J8.1, R202.1
unnamed: J8.2, R234.2
unnamed: J8.3, R203.1
unnamed: J8.4, R235.2
unnamed: J8.5, R204.1
unnamed: J8.6, R236.2
unnamed: J8.7, R205.1
unnamed: J8.8, R237.2
unnamed: J8.9, R206.1
unnamed: J8.10, R238.2
unnamed: J8.11, R207.1
unnamed: J8.12, R239.2
unnamed: J8.13, R208.1
unnamed: J8.14, R240.2
unnamed: J8.15, R209.1
unnamed: J8.16, R241.2
unnamed: J8.17, R210.1
unnamed: J8.18, R242.2
unnamed: J8.19, R211.1
unnamed: J8.20, R243.2
unnamed: J8.21, R212.1
unnamed: J8.22, R244.2
unnamed: J8.23, R213.1
unnamed: J8.24, R245.2
unnamed: J8.25, R214.1
unnamed: J8.26, R246.2
unnamed: J8.27, R215.1
unnamed: J8.28, R247.2
unnamed: J8.29, R216.1
unnamed: J8.30, R248.2
unnamed: J8.31, R217.1
unnamed: J8.32, R249.2

Notes on the sheet:
No pulldown resistors used on data lines since they are only floating at startup.
Blue channel
Connectors
Decoder Blue
Connectors for blue LED channel.

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
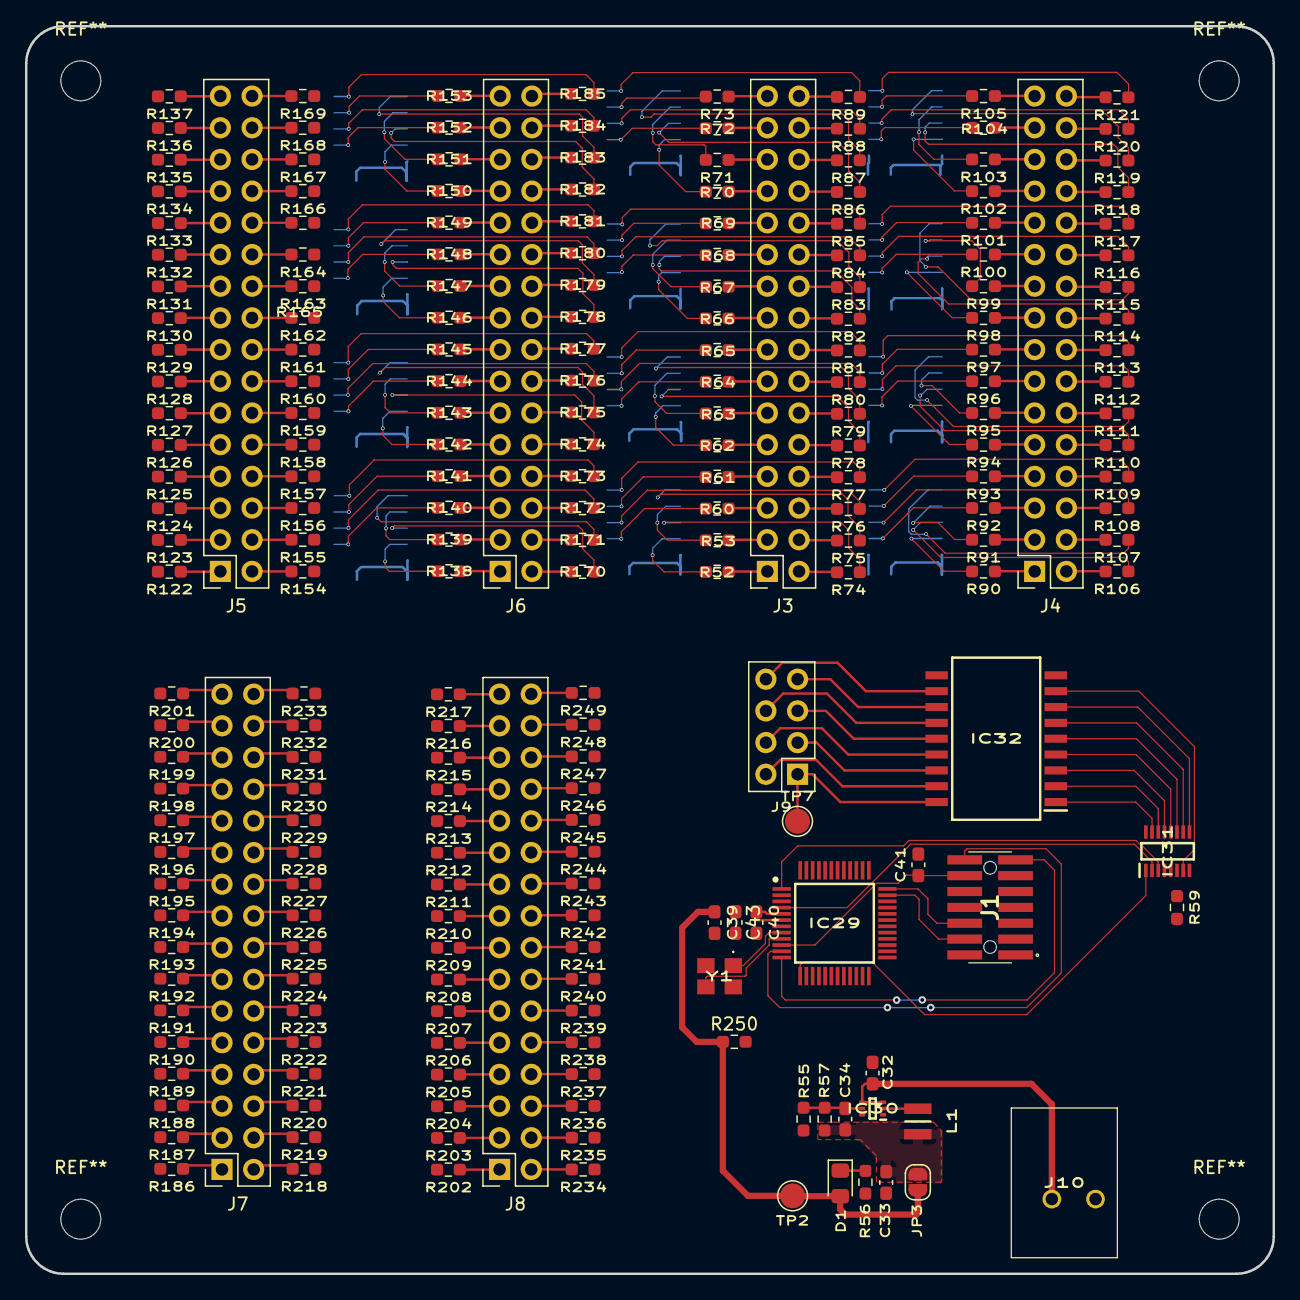
[picture p6: board LED_CUBE_8x8.kicad_pcb from above]

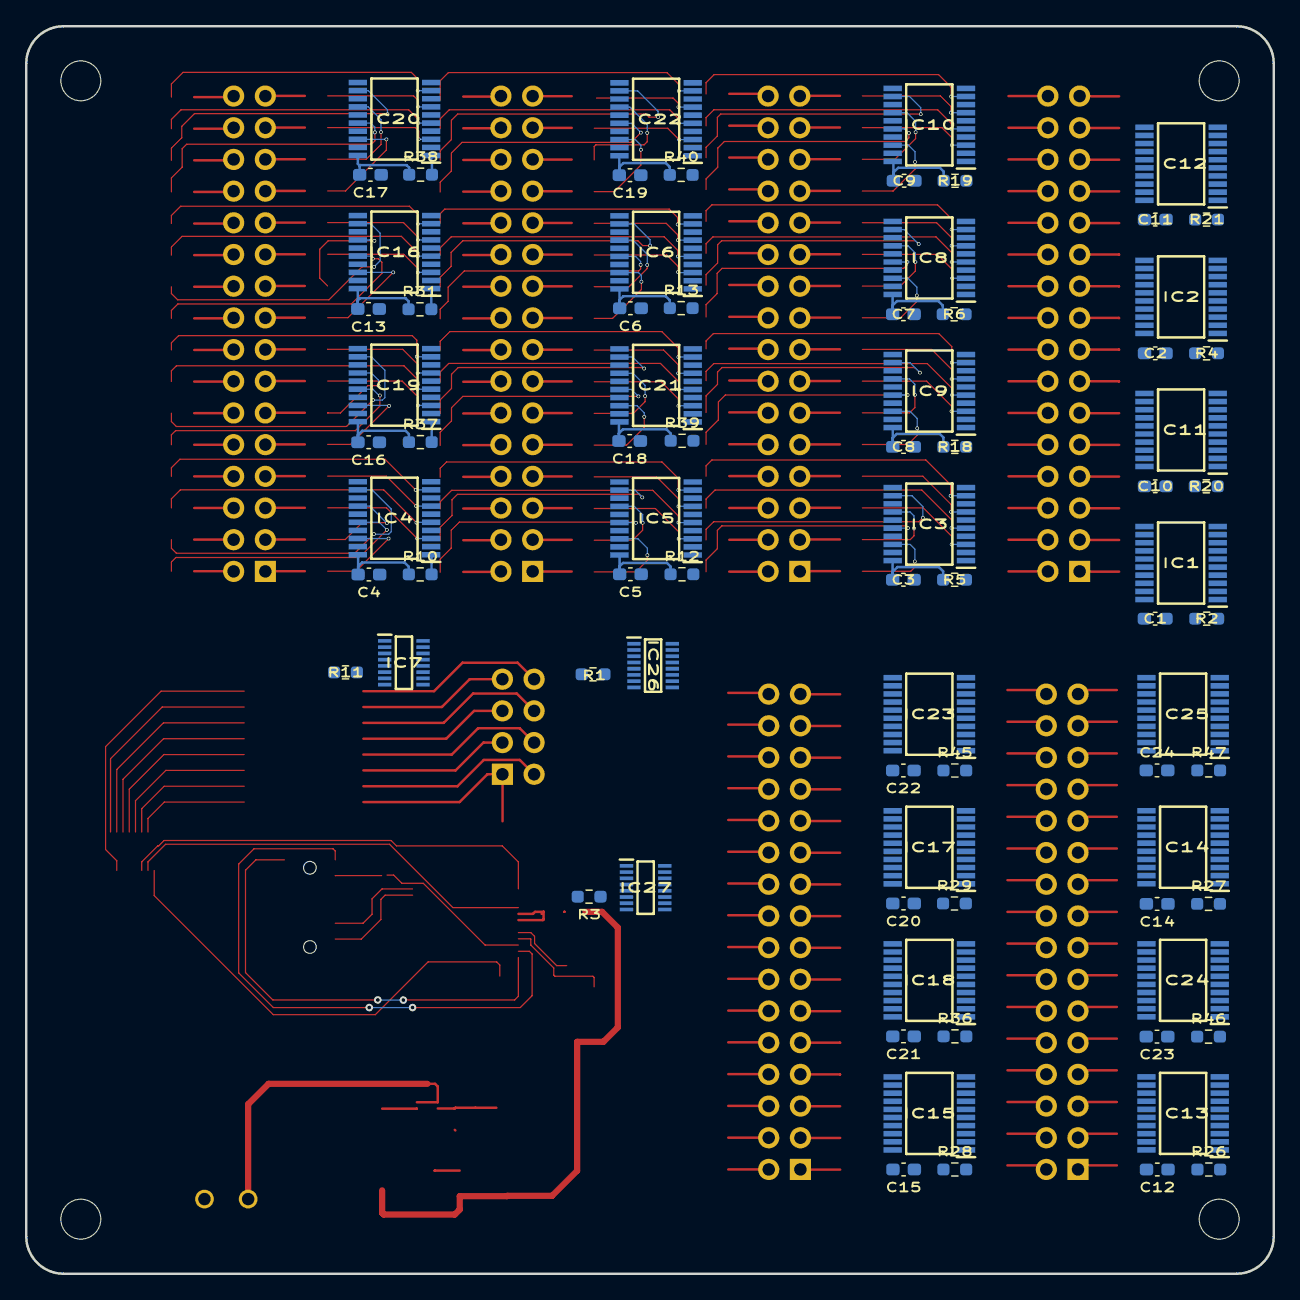
[picture p7: board LED_CUBE_8x8.kicad_pcb from below]

Board: 4 copper layers, 100.0 x 100.0 mm, 301 parts (78 on the bottom side), 478 nets.

Other parts of the board:
R250: R10K; R_0603_1608Metric_Pad0.98x0.95mm_HandSolder

Their connections:
+3.3V: R250.1; also elsewhere on the board
NRST: R250.2; also elsewhere on the board
