LarsMolenschot/8x8_RGB_LED_CUBE/(commit log)

2025-07-20 added initial KICAD files in addition with the samasyc parts which include the symbols and footprints for the various IC's.
    [LED_CUBE_8x8.kicad_pcb, LED_CUBE_8x8.kicad_sch]
2025-07-20 changed KICAD symbol and footprint libraries to use local path relative to project folder.
2025-07-20 cleaning repository after gitignore
    [LED_CUBE_8x8.kicad_pcb, LED_CUBE_8x8.kicad_sch]
2025-07-20 restoring KICAD project files
    [LED_CUBE_8x8.kicad_pcb, LED_CUBE_8x8.kicad_sch]
2025-07-20 added datasheets of the IC's used for the PCB
2025-07-23 added the decoder and buffer IC's to the schematic.
    [LED_CUBE_8x8.kicad_sch]
2025-07-26 changed buffer to a 5V tolerant one and worked on the schematic.
    [LED_CUBE_8x8.kicad_sch]
2025-07-26 Made progress on schematic red channel multiplexing almost finished.
    [Blue_LEDS.kicad_sch, Green_LEDS.kicad_sch, LED_CUBE_8x8.kicad_sch, Red_LEDS.kicad_sch, untitled.kicad_sch]
2025-07-27 Finished the schematic for the red green and blue color multiplexing.
    [Blue_LEDS.kicad_sch, Green_LEDS.kicad_sch, LED_CUBE_8x8.kicad_sch, Red_LEDS.kicad_sch]
2025-07-31 added power schematic and updated labels to correct type e.g. output, input
    [Green_LEDS.kicad_sch, LED_CUBE_8x8.kicad_sch, Power.kicad_sch, Red_LEDS.kicad_sch]
2025-08-04 added 3.3V power supply for microcontroller and started on STM schematic.
    [Blue_LEDS.kicad_sch, Green_LEDS.kicad_sch, LED_CUBE_8x8.kicad_sch, Power.kicad_sch, STM32_sch.kicad_sch]
2025-08-31 WIP: need to add connectors for the LED channels
    [Power.kicad_sch, STM32_sch.kicad_sch]
2025-09-27 WIP: added layer select schematic
    [LED_CUBE_8x8.kicad_sch, Layer_select.kicad_sch, STM32_sch.kicad_sch]
2025-10-01 added connector and current limiting resistors of the RED channel.
    [Red_LEDS.kicad_sch]
2026-03-13 added spice simulations folder, For simulating transients effect on the power buck converter. Also finished layer select in eeschema.
    [Blue_LEDS.kicad_sch, Green_LEDS.kicad_sch, Layer_select.kicad_sch, Red_LEDS.kicad_sch, TPS562202DRL_TRANS.OLB, TPS562202_TRANS.OPJ]
2026-04-18 updated to KICAD v10
    [Blue_LEDS.kicad_sch, Green_LEDS.kicad_sch, LED_CUBE_8x8.kicad_sch, Layer_select.kicad_sch, Power.kicad_sch, Red_LEDS.kicad_sch, STM32_sch.kicad_sch]
2026-04-18 removed the untitled schematic
    [untitled.kicad_sch]
2026-04-18 Added test points and solder jumpers
    [Blue_LEDS.kicad_sch, Green_LEDS.kicad_sch, Layer_select.kicad_sch, Power.kicad_sch, Red_LEDS.kicad_sch, STM32_sch.kicad_sch]
2026-07-14 Finalized schematic changed power source and buck converter due to unavailability stock mouser. Also assigned all the footprints to all components and ran ERC.
    [Blue_LEDS.kicad_sch, Green_LEDS.kicad_sch, LED_CUBE_8x8.kicad_sch, Layer_select.kicad_sch, Power.kicad_sch, Red_LEDS.kicad_sch, STM32_sch.kicad_sch]
2026-08-04 start of PCB layout
    [Blue_LEDS.kicad_sch, Green_LEDS.kicad_sch, LED_CUBE_8x8.kicad_pcb, Layer_select.kicad_sch, Red_LEDS.kicad_sch, STM32_sch.kicad_sch]
2026-08-11 Top layer placement done revised the SWD connector and started routing.
    [Blue_LEDS.kicad_sch, Green_LEDS.kicad_sch, LED_CUBE_8x8.kicad_pcb, Red_LEDS.kicad_sch, STM32_sch.kicad_sch]
2026-08-15 Progressed with routing traces back of PCB.
    [Blue_LEDS.kicad_sch, LED_CUBE_8x8.kicad_pcb]
